hamdy-cryptic/Smart-Glove/Docs/pcb.pdf

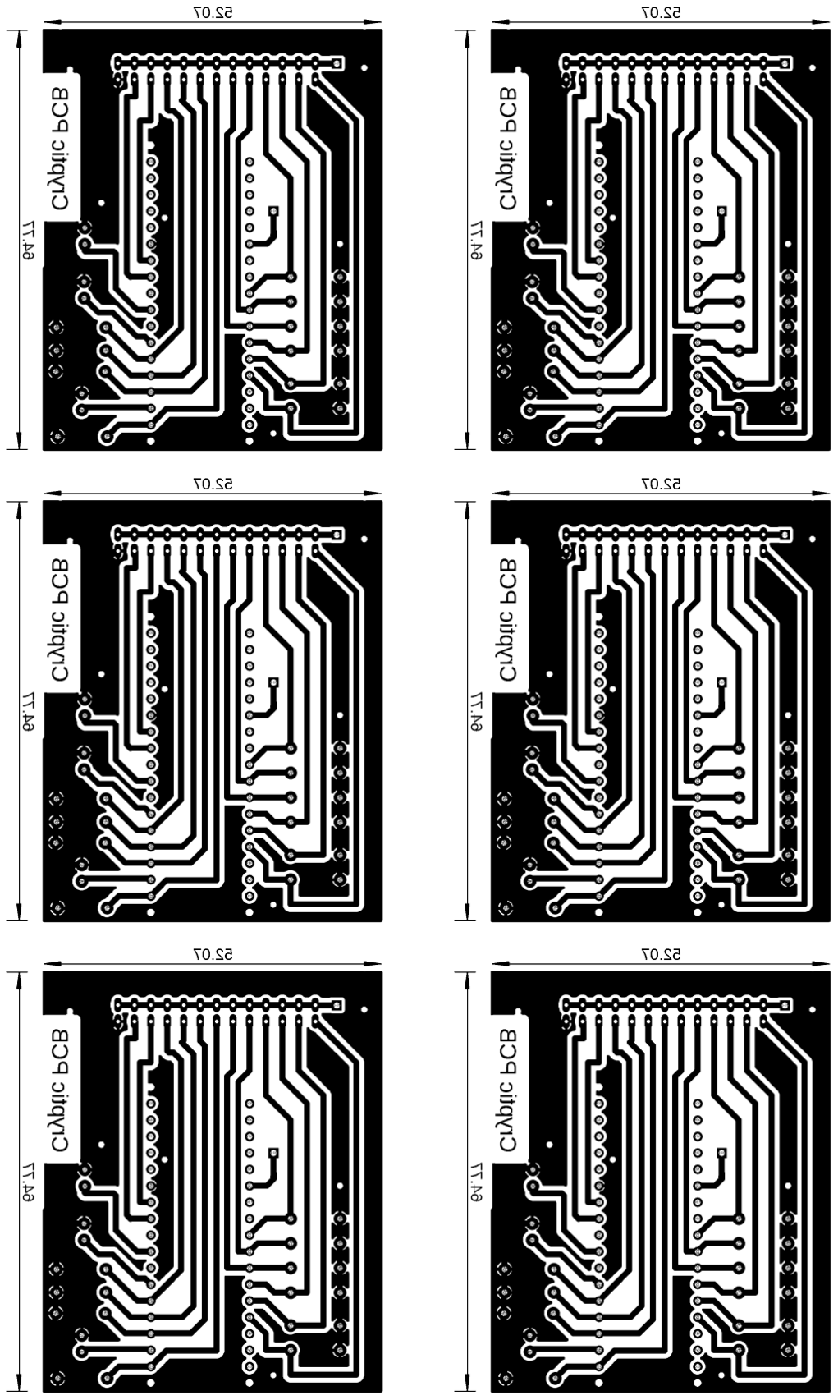
[picture p6: figure]
